cvalenciaMEMSYS/UniversalMotorModule/Motor_comparison/STSPIN220 new driver/M1/M1_summary_table.md

# M1 — Energy Measurement Results

Generated: 2026-02-09 14:13:06

## Complete Test Matrix

| Test ID | Speed | Voltage | Dir | Mean Power (mW) | Peak Power (mW) | Peak I (mA) | Energy (mJ) | Duration (ms) | Max Thrust (N) |
|---|---|---|-----|---|---|---|---|---|---|
| M1-CVH-4 | 10000 | 4V | N | 937 | 1375 | 390 | 1063 | 1134 | 5.19 |
| M1-CVH-5 | 10000 | 5V | N | 1425 | 2065 | 442 | 1652 | 1159 | 5.93 |
| M1-CVH-6 | 10000 | 6V | N | 1712 | 2554 | 456 | 1943 | 1135 | 6.47 |

## Best Configuration Summary

| Goal | Test ID | Speed | Voltage | Mean Power (mW) | Energy (mJ) | Max Thrust (N) | Efficiency (mJ/N) |
|---|---|---|---|---|---|---|---|
| **Min Energy** | M1-CVH-4 | 10000 | 4V | 937 | 1063 | 5.19 | 204.6 |
| **Max Thrust** | M1-CVH-6 | 10000 | 6V | 1712 | 1943 | 6.47 | 300.2 |
| **Best Efficiency** | M1-CVH-4 | 10000 | 4V | 937 | 1063 | 5.19 | 204.6 |
| **Balanced (5V)** | M1-CVH-5 | 10000 | 5V | 1425 | 1652 | 5.93 | 278.5 |
