cvalenciaMEMSYS/UniversalMotorModule/Motor_comparison/STSPIN220 new driver/M2/M2_summary_table.md

# M2 — Energy Measurement Results

Generated: 2026-02-09 14:27:09

## Complete Test Matrix

| Test ID | Speed | Voltage | Dir | Mean Power (mW) | Peak Power (mW) | Peak I (mA) | Energy (mJ) | Duration (ms) | Max Thrust (N) |
|---|---|---|-----|---|---|---|---|---|---|
| M2-CVH-3 | 10000 | 3V | N | 426 | 682 | 247 | 262 | 614 | 4.31 |
| M2-CVH-4 | 10000 | 4V | N | 760 | 1151 | 300 | 458 | 602 | 6.34 |
| M2-CVH-5 | 10000 | 5V | N | 1171 | 1672 | 359 | 715 | 610 | 7.03 |
| M2-CVH-6 | 10000 | 6V | N | 1514 | 2251 | 379 | 943 | 623 | 7.87 |
| M2-CUH-2 | 20000 | 2V | N | 154 | 273 | 152 | 58 | 377 | 2.71 |
| M2-CUH-3 | 20000 | 3V | N | 368 | 615 | 222 | 138 | 375 | 3.98 |

## Best Configuration Summary

| Goal | Test ID | Speed | Voltage | Mean Power (mW) | Energy (mJ) | Max Thrust (N) | Efficiency (mJ/N) |
|---|---|---|---|---|---|---|---|
| **Min Energy** | M2-CUH-2 | 20000 | 2V | 154 | 58 | 2.71 | 21.4 |
| **Max Thrust** | M2-CVH-6 | 10000 | 6V | 1514 | 943 | 7.87 | 119.9 |
| **Best Efficiency** | M2-CUH-2 | 20000 | 2V | 154 | 58 | 2.71 | 21.4 |
| **Balanced (5V)** | M2-CVH-5 | 10000 | 5V | 1171 | 715 | 7.03 | 101.6 |
