cvalenciaMEMSYS/UniversalMotorModule/Motor_comparison/DC Motors/D4/Constant load/D4_summary_table.md

# D4 — Energy Measurement Results

Generated: 2026-03-26 16:34:23

## Complete Test Matrix

| Test ID | Type | Speed | Voltage | Dir | Mean Power (mW) | Peak Power (mW) | Peak I (mA) | Energy (mJ) | Duration (ms) | Max Thrust (N) |
|---|---|---|---|-----|---|---|---|---|---|---|
| D4-CL-300g-3V3-N | CL | 100 | 3.3V | N | 72 | 215 | 65 | 1257 | 17509 | N/A |
| D4-CL-580g-3V3-N | CL | 100 | 3.3V | N | 99 | 225 | 68 | 1996 | 20163 | N/A |
| D4-CL-300g-6V-N | CL | 100 | 6.0V | N | 142 | 709 | 119 | 1246 | 8773 | N/A |
| D4-CL-580g-6V-N | CL | 100 | 6.0V | N | 188 | 711 | 119 | 1782 | 9468 | N/A |

## Best Configuration Summary

| Goal | Test ID | Type | Speed | Voltage | Mean Power (mW) | Energy (mJ) | Max Thrust (N) | Efficiency (mJ/N) |
|---|---|---|---|---|---|---|---|---|
| **Min Energy** | D4-CL-300g-6V-N | CL | 100 | 6.0V | 142 | 1246 | N/A | N/A |
