cvalenciaMEMSYS/UniversalMotorModule/Motor_comparison/DC Motors/D4/Held back/D4_summary_table.md

# D4 — Energy Measurement Results

Generated: 2026-03-26 15:02:04

## Complete Test Matrix

| Test ID | Type | Speed | Voltage | Dir | Mean Power (mW) | Peak Power (mW) | Peak I (mA) | Energy (mJ) | Duration (ms) | Max Thrust (N) |
|---|---|---|---|-----|---|---|---|---|---|---|
| D4-DC-3 | DC | 100% | 3V | N | 143 | 252 | 77 | 725 | 5057 | 13.35 |
| D4-DC-4 | DC | 100% | 4V | N | 228 | 392 | 99 | 1150 | 5054 | 14.95 |
| D4-DC-5 | DC | 100% | 5V | N | 228 | 489 | 98 | 1386 | 6089 | 15.44 |
| D4-DC-6 | DC | 100% | 6V | N | 266 | 708 | 118 | 1614 | 6075 | 14.50 |

## Best Configuration Summary

| Goal | Test ID | Type | Speed | Voltage | Mean Power (mW) | Energy (mJ) | Max Thrust (N) | Efficiency (mJ/N) |
|---|---|---|---|---|---|---|---|---|
| **Min Energy** | D4-DC-3 | DC | 100% | 3V | 143 | 725 | 13.35 | 54.3 |
| **Max Thrust** | D4-DC-5 | DC | 100% | 5V | 228 | 1386 | 15.44 | 89.8 |
| **Best Efficiency** | D4-DC-3 | DC | 100% | 3V | 143 | 725 | 13.35 | 54.3 |
| **Balanced (5V)** | D4-DC-5 | DC | 100% | 5V | 228 | 1386 | 15.44 | 89.8 |
