cvalenciaMEMSYS/UniversalMotorModule/Motor_comparison/DC Motors/D1/Fixed mounting/D1_fixed_summary_table.md

# D1 — Energy Measurement Results

Generated: 2026-02-17 10:46:12

## Complete Test Matrix

| Test ID | Type | Speed | Voltage | Dir | Mean Power (mW) | Peak Power (mW) | Peak I (mA) | Energy (mJ) | Duration (ms) | Max Thrust (N) |
|---|---|---|---|-----|---|---|---|---|---|---|
| D1-DC-3 | DC | 100% | 3V | N | 90 | 234 | 78 | 2168 | 23993 | 7.96 |
| D1-DC-4 | DC | 100% | 4V | N | 243 | 358 | 90 | 5825 | 23942 | 14.18 |
| D1-DC-5 | DC | 100% | 5V | N | 237 | 522 | 104 | 5664 | 23906 | 20.74 |
| D1-DC-6 | DC | 100% | 6V | N | 296 | 697 | 116 | 7077 | 23928 | 24.12 |

## Best Configuration Summary

| Goal | Test ID | Type | Speed | Voltage | Mean Power (mW) | Energy (mJ) | Max Thrust (N) | Efficiency (mJ/N) |
|---|---|---|---|---|---|---|---|---|
| **Min Energy** | D1-DC-3 | DC | 100% | 3V | 90 | 2168 | 7.96 | 272.3 |
| **Max Thrust** | D1-DC-6 | DC | 100% | 6V | 296 | 7077 | 24.12 | 293.5 |
| **Best Efficiency** | D1-DC-3 | DC | 100% | 3V | 90 | 2168 | 7.96 | 272.3 |
| **Balanced (5V)** | D1-DC-5 | DC | 100% | 5V | 237 | 5664 | 20.74 | 273.1 |
