cvalenciaMEMSYS/UniversalMotorModule/Motor_comparison/DC Motors/D1/Held back/D1_summary_table.md

# D1 — Energy Measurement Results

Generated: 2026-02-17 10:41:56

## Complete Test Matrix

| Test ID | Type | Speed | Voltage | Dir | Mean Power (mW) | Peak Power (mW) | Peak I (mA) | Energy (mJ) | Duration (ms) | Max Thrust (N) |
|---|---|---|---|-----|---|---|---|---|---|---|
| D1-DC-2 | DC | 100% | 2V | N | 48 | 115 | 48 | 1158 | 23961 | 28.42 |
| D1-DC-3 | DC | 100% | 3V | N | 80 | 178 | 59 | 1916 | 23951 | 37.58 |
| D1-DC-4 | DC | 100% | 4V | N | 115 | 316 | 79 | 2760 | 23980 | 45.05 |
| D1-DC-5 | DC | 100% | 5V | N | 204 | 492 | 98 | 4876 | 23870 | 55.33 |
| D1-DC-6 | DC | 100% | 6V | N | 229 | 697 | 116 | 5465 | 23889 | 54.54 |

## Best Configuration Summary

| Goal | Test ID | Type | Speed | Voltage | Mean Power (mW) | Energy (mJ) | Max Thrust (N) | Efficiency (mJ/N) |
|---|---|---|---|---|---|---|---|---|
| **Min Energy** | D1-DC-2 | DC | 100% | 2V | 48 | 1158 | 28.42 | 40.7 |
| **Max Thrust** | D1-DC-5 | DC | 100% | 5V | 204 | 4876 | 55.33 | 88.1 |
| **Best Efficiency** | D1-DC-2 | DC | 100% | 2V | 48 | 1158 | 28.42 | 40.7 |
| **Balanced (5V)** | D1-DC-5 | DC | 100% | 5V | 204 | 4876 | 55.33 | 88.1 |
