cvalenciaMEMSYS/UniversalMotorModule/Motor_comparison/DC Motors/D2/Held back Constant load/D2_ConstantLoad300g_summary_table.md

# D2 — Energy Measurement Results

Generated: 2026-02-17 10:52:14

## Complete Test Matrix

| Test ID | Type | Speed | Voltage | Dir | Mean Power (mW) | Peak Power (mW) | Peak I (mA) | Energy (mJ) | Duration (ms) | Max Thrust (N) |
|---|---|---|---|-----|---|---|---|---|---|---|
| D2-DC-6 | DC | 100% | 6V | N | 153 | 657 | 110 | 3369 | 22077 | N/A |

## Best Configuration Summary

| Goal | Test ID | Type | Speed | Voltage | Mean Power (mW) | Energy (mJ) | Max Thrust (N) | Efficiency (mJ/N) |
|---|---|---|---|---|---|---|---|---|
| **Min Energy** | D2-DC-6 | DC | 100% | 6V | 153 | 3369 | N/A | N/A |
