cvalenciaMEMSYS/UniversalMotorModule/Motor_comparison/DC Motors/D2/Held back Constant load/D2_ConstantLoad580g_summary_table.md

# D2 — Energy Measurement Results

Generated: 2026-02-17 10:54:47

## Complete Test Matrix

| Test ID | Type | Speed | Voltage | Dir | Mean Power (mW) | Peak Power (mW) | Peak I (mA) | Energy (mJ) | Duration (ms) | Max Thrust (N) |
|---|---|---|---|-----|---|---|---|---|---|---|
| D2-DC-6 | DC | 100% | 6V | N | 186 | 658 | 111 | 4108 | 22130 | N/A |

## Best Configuration Summary

| Goal | Test ID | Type | Speed | Voltage | Mean Power (mW) | Energy (mJ) | Max Thrust (N) | Efficiency (mJ/N) |
|---|---|---|---|---|---|---|---|---|
| **Min Energy** | D2-DC-6 | DC | 100% | 6V | 186 | 4108 | N/A | N/A |
