cvalenciaMEMSYS/UniversalMotorModule/Motor_comparison/DC Motors/D2/Held back/D2_summary_table.md

# D2 — Energy Measurement Results

Generated: 2026-02-17 10:58:02

## Complete Test Matrix

| Test ID | Type | Speed | Voltage | Dir | Mean Power (mW) | Peak Power (mW) | Peak I (mA) | Energy (mJ) | Duration (ms) | Max Thrust (N) |
|---|---|---|---|-----|---|---|---|---|---|---|
| D2-DC-2 | DC | 100% | 2V | N | 68 | 128 | 54 | 501 | 7353 | 15.80 |
| D2-DC-3 | DC | 100% | 3V | N | 108 | 185 | 62 | 798 | 7382 | 19.82 |
| D2-DC-4 | DC | 100% | 4V | N | 191 | 341 | 85 | 1405 | 7350 | 29.23 |
| D2-DC-5 | DC | 100% | 5V | N | 283 | 529 | 106 | 2091 | 7384 | 36.66 |
| D2-DC-6 | DC | 100% | 6V | N | 309 | 757 | 127 | 2274 | 7370 | 48.26 |

## Best Configuration Summary

| Goal | Test ID | Type | Speed | Voltage | Mean Power (mW) | Energy (mJ) | Max Thrust (N) | Efficiency (mJ/N) |
|---|---|---|---|---|---|---|---|---|
| **Min Energy** | D2-DC-2 | DC | 100% | 2V | 68 | 501 | 15.80 | 31.7 |
| **Max Thrust** | D2-DC-6 | DC | 100% | 6V | 309 | 2274 | 48.26 | 47.1 |
| **Best Efficiency** | D2-DC-2 | DC | 100% | 2V | 68 | 501 | 15.80 | 31.7 |
| **Balanced (5V)** | D2-DC-5 | DC | 100% | 5V | 283 | 2091 | 36.66 | 57.0 |
