cvalenciaMEMSYS/UniversalMotorModule/Motor_comparison/DC Motors/D3/Held back/D3_summary_table.md

# D3 — Energy Measurement Results

Generated: 2026-02-17 11:03:01

## Complete Test Matrix

| Test ID | Type | Speed | Voltage | Dir | Mean Power (mW) | Peak Power (mW) | Peak I (mA) | Energy (mJ) | Duration (ms) | Max Thrust (N) |
|---|---|---|---|-----|---|---|---|---|---|---|
| D3-DC-3 | DC | 100% | 3V | N | 80 | 213 | 71 | 82 | 1027 | 3.07 |
| D3-DC-4 | DC | 100% | 4V | N | 100 | 386 | 97 | 103 | 1030 | 4.13 |
| D3-DC-5 | DC | 100% | 5V | N | 334 | 518 | 104 | 345 | 1032 | 4.97 |
| D3-DC-6 | DC | 100% | 6V | N | 436 | 797 | 134 | 445 | 1023 | 6.50 |

## Best Configuration Summary

| Goal | Test ID | Type | Speed | Voltage | Mean Power (mW) | Energy (mJ) | Max Thrust (N) | Efficiency (mJ/N) |
|---|---|---|---|---|---|---|---|---|
| **Min Energy** | D3-DC-3 | DC | 100% | 3V | 80 | 82 | 3.07 | 26.7 |
| **Max Thrust** | D3-DC-6 | DC | 100% | 6V | 436 | 445 | 6.50 | 68.5 |
| **Best Efficiency** | D3-DC-4 | DC | 100% | 4V | 100 | 103 | 4.13 | 24.9 |
| **Balanced (5V)** | D3-DC-5 | DC | 100% | 5V | 334 | 345 | 4.97 | 69.4 |
