cvalenciaMEMSYS/UniversalMotorModule/Motor_comparison/M1/M1_summary_table.md

# M1 — Energy Measurement Results

Generated: 2026-01-30 14:25:04

## Complete Test Matrix

| Test ID | Speed | Voltage | Dir | Mean Power (mW) | Peak Power (mW) | Peak I (mA) | Energy (mJ) | Duration (ms) | Max Thrust (N) |
|---|---|---|-----|---|---|---|---|---|---|
| M1-CVL-4 | 100 | 4V | N | 534 | 1329 | 344 | 16365 | 30625 | 4.42 |
| M1-CVL-5 | 100 | 5V | N | 813 | 2080 | 412 | 20814 | 25602 | 4.59 |
| M1-CVL-6 | 100 | 6V | N | 1063 | 2920 | 507 | 27117 | 25518 | 4.99 |
| M1-CL-4 | 500 | 4V | N | 364 | 1245 | 296 | 3819 | 10501 | 3.67 |
| M1-CL-5 | 500 | 5V | N | 651 | 2055 | 371 | 6850 | 10517 | 4.61 |
| M1-CL-6 | 500 | 6V | N | 595 | 2329 | 408 | 6247 | 10502 | 4.70 |
| M1-CM-4 | 2000 | 4V | N | 340 | 1253 | 300 | 951 | 2795 | 3.89 |
| M1-CM-5 | 2000 | 5V | N | 574 | 2122 | 377 | 1597 | 2782 | 5.16 |
| M1-CM-6 | 2000 | 6V | N | 636 | 2996 | 501 | 1774 | 2788 | 5.07 |
| M1-CH-4 | 5000 | 4V | N | 506 | 1373 | 337 | 701 | 1385 | 4.89 |
| M1-CH-5 | 5000 | 5V | N | 837 | 2201 | 428 | 1182 | 1412 | 5.69 |
| M1-CH-6 | 5000 | 6V | N | 804 | 2375 | 451 | 1141 | 1418 | 5.42 |
| M1-CVH-4 | 10000 | 4V | N | 298 | 1399 | 343 | 412 | 1386 | 3.65 |
| M1-TVH-4 | 10000 | 4V | N | 364 | 1320 | 321 | 1605 | 4404 | 4.37 |
| M1-CVH-4-R | 10000 | 4V | R | 265 | 1396 | 342 | 375 | 1416 | N/A |
| M1-CVH-5 | 10000 | 5V | N | 485 | 2271 | 428 | 673 | 1389 | 4.83 |
| M1-CVH-5-R | 10000 | 5V | R | 448 | 2269 | 431 | 628 | 1401 | N/A |
| M1-CVH-6 | 10000 | 6V | N | 517 | 3302 | 494 | 723 | 1398 | 5.18 |
| M1-TVH-6 | 10000 | 6V | N | 666 | 2944 | 445 | 3019 | 4534 | N/A |
| M1-CVH-6-R | 10000 | 6V | R | 482 | 3145 | 472 | 666 | 1381 | N/A |

## Backdrive Force Results

| Test ID | Direction | Max Force (N) | Mean Force (N) |
|---|---|---|---|
| M1-BD-OFF-Rigid | Rigid | 10.39 | 2.80 |
| M1-BD-OFF-Spring | Spring | 8.17 | 4.63 |

## Best Configuration Summary

| Goal | Test ID | Speed | Voltage | Mean Power (mW) | Energy (mJ) | Max Thrust (N) | Efficiency (mJ/N) |
|---|---|---|---|---|---|---|---|
| **Min Energy** | M1-CVH-4-R | 10000 | 4V | 265 | 375 | N/A | N/A |
| **Max Thrust** | M1-CH-5 | 5000 | 5V | 837 | 1182 | 5.69 | 207.6 |
| **Best Efficiency** | M1-CVH-4 | 10000 | 4V | 298 | 412 | 3.65 | 112.9 |
| **Balanced (5V)** | M1-CVH-5 | 10000 | 5V | 485 | 673 | 4.83 | 139.3 |
