cvalenciaMEMSYS/UniversalMotorModule/Motor_comparison/M2/M2_summary_table.md

# M2 — Energy Measurement Results

Generated: 2026-01-30 14:49:28

## Complete Test Matrix

| Test ID | Speed | Voltage | Dir | Mean Power (mW) | Peak Power (mW) | Peak I (mA) | Energy (mJ) | Duration (ms) | Max Thrust (N) |
|---|---|---|-----|---|---|---|---|---|---|
| M2-CL-4 | 500 | 4V | N | 405 | 987 | 253 | 4265 | 10539 | 3.83 |
| M2-CL-4-R | 500 | 4V | R | 400 | 982 | 254 | 4193 | 10484 | 3.83 |
| M2-CL-5 | 500 | 5V | N | 602 | 1512 | 318 | 6321 | 10504 | 4.76 |
| M2-CL-5-R | 500 | 5V | R | 597 | 1508 | 315 | 6206 | 10402 | 5.72 |
| M2-CL-6 | 500 | 6V | N | 867 | 2294 | 364 | 9051 | 10442 | 6.51 |
| M2-CL-6-R | 500 | 6V | R | 862 | 2253 | 363 | 8987 | 10429 | N/A |
| M2-CVH-4 | 10000 | 4V | N | 264 | 1096 | 256 | 216 | 819 | 3.94 |
| M2-CVH-4-R | 10000 | 4V | R | 291 | 1053 | 251 | 231 | 794 | 3.94 |
| M2-CVH-5 | 10000 | 5V | N | 424 | 1726 | 324 | 339 | 800 | 5.74 |
| M2-CVH-5-R | 10000 | 5V | R | 430 | 1688 | 334 | 332 | 771 | 5.95 |
| M2-CVH-6 | 10000 | 6V | N | 572 | 2459 | 387 | 450 | 786 | 6.06 |
| M2-CVH-6-R | 10000 | 6V | R | 568 | 2413 | 383 | 457 | 805 | 6.06 |

## Backdrive Force Results

| Test ID | Direction | Max Force (N) | Mean Force (N) |
|---|---|---|---|
| M2-BD-OFF-N | N | 11.57 | 2.38 |
| M2-BD-OFF-R | R | 11.63 | 4.29 |

## Best Configuration Summary

| Goal | Test ID | Speed | Voltage | Mean Power (mW) | Energy (mJ) | Max Thrust (N) | Efficiency (mJ/N) |
|---|---|---|---|---|---|---|---|
| **Min Energy** | M2-CVH-4 | 10000 | 4V | 264 | 216 | 3.94 | 54.8 |
| **Max Thrust** | M2-CL-6 | 500 | 6V | 867 | 9051 | 6.51 | 1389.5 |
| **Best Efficiency** | M2-CVH-4 | 10000 | 4V | 264 | 216 | 3.94 | 54.8 |
| **Balanced (5V)** | M2-CVH-5-R | 10000 | 5V | 430 | 332 | 5.95 | 55.8 |
