cvalenciaMEMSYS/UniversalMotorModule/Motor_comparison/DC Motors/D1/Fixed mounting/D1_fixed_best_efficiency_raw_force.png

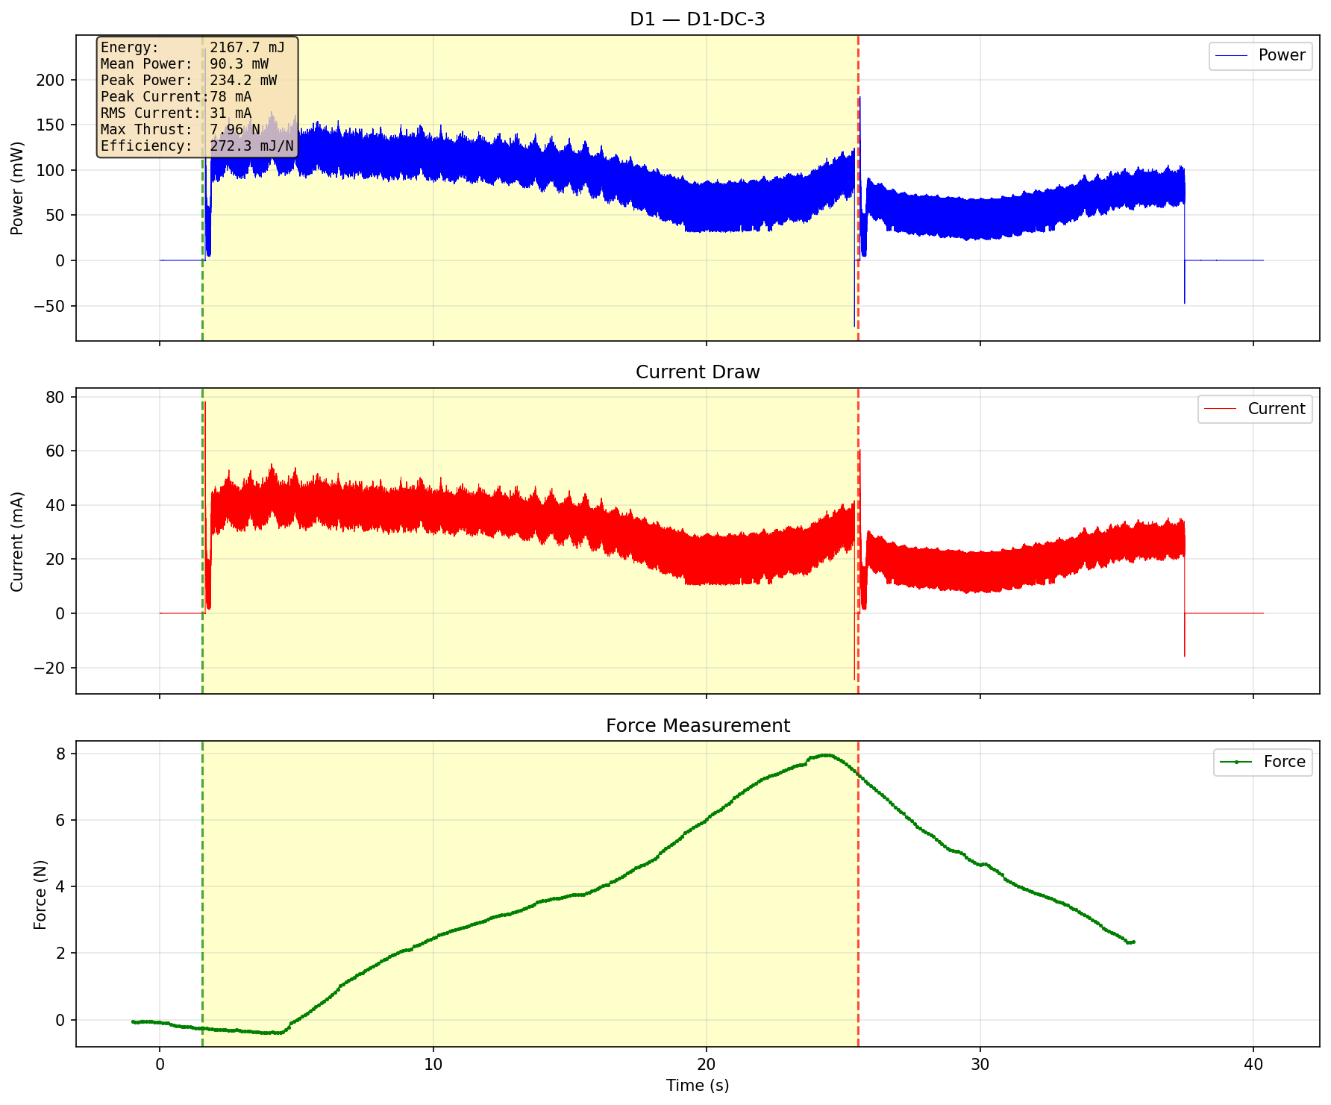
Motor_comparison/DC Motors/D1/Fixed mounting/D1_fixed_best_efficiency_raw_force.png
