cvalenciaMEMSYS/UniversalMotorModule/Motor_comparison/DC Motors/D1/Held back/D1_best_efficiency_raw_force.png

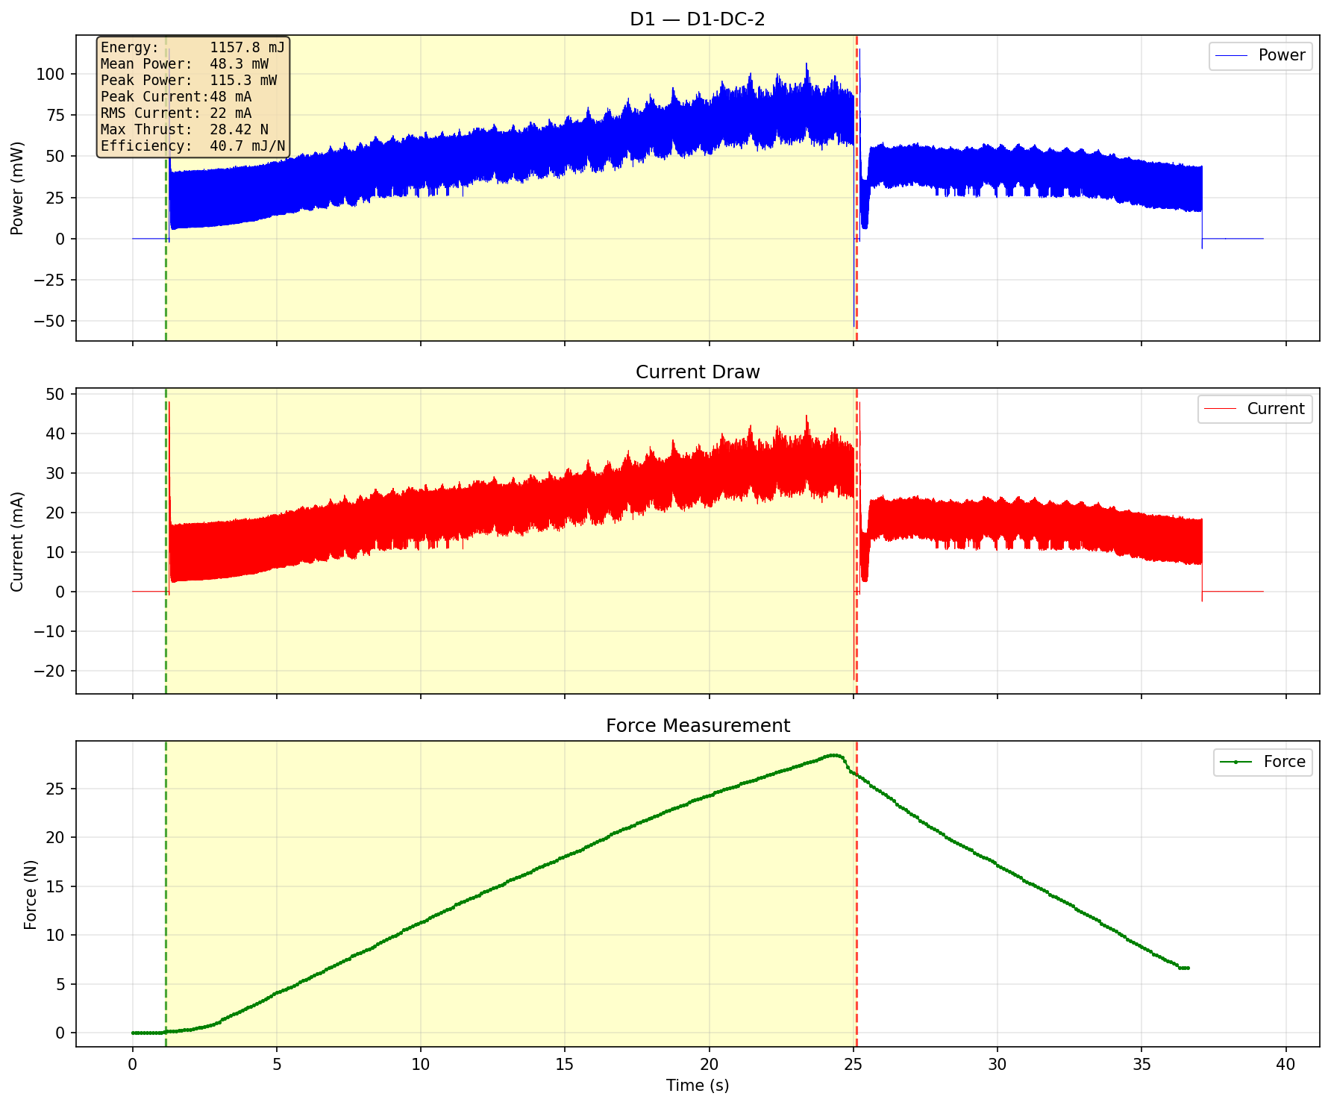
Motor_comparison/DC Motors/D1/Held back/D1_best_efficiency_raw_force.png
