cvalenciaMEMSYS/UniversalMotorModule/Motor_comparison/DC Motors/D2/Held back Constant load/D2_ConstantLoad300g_config.png

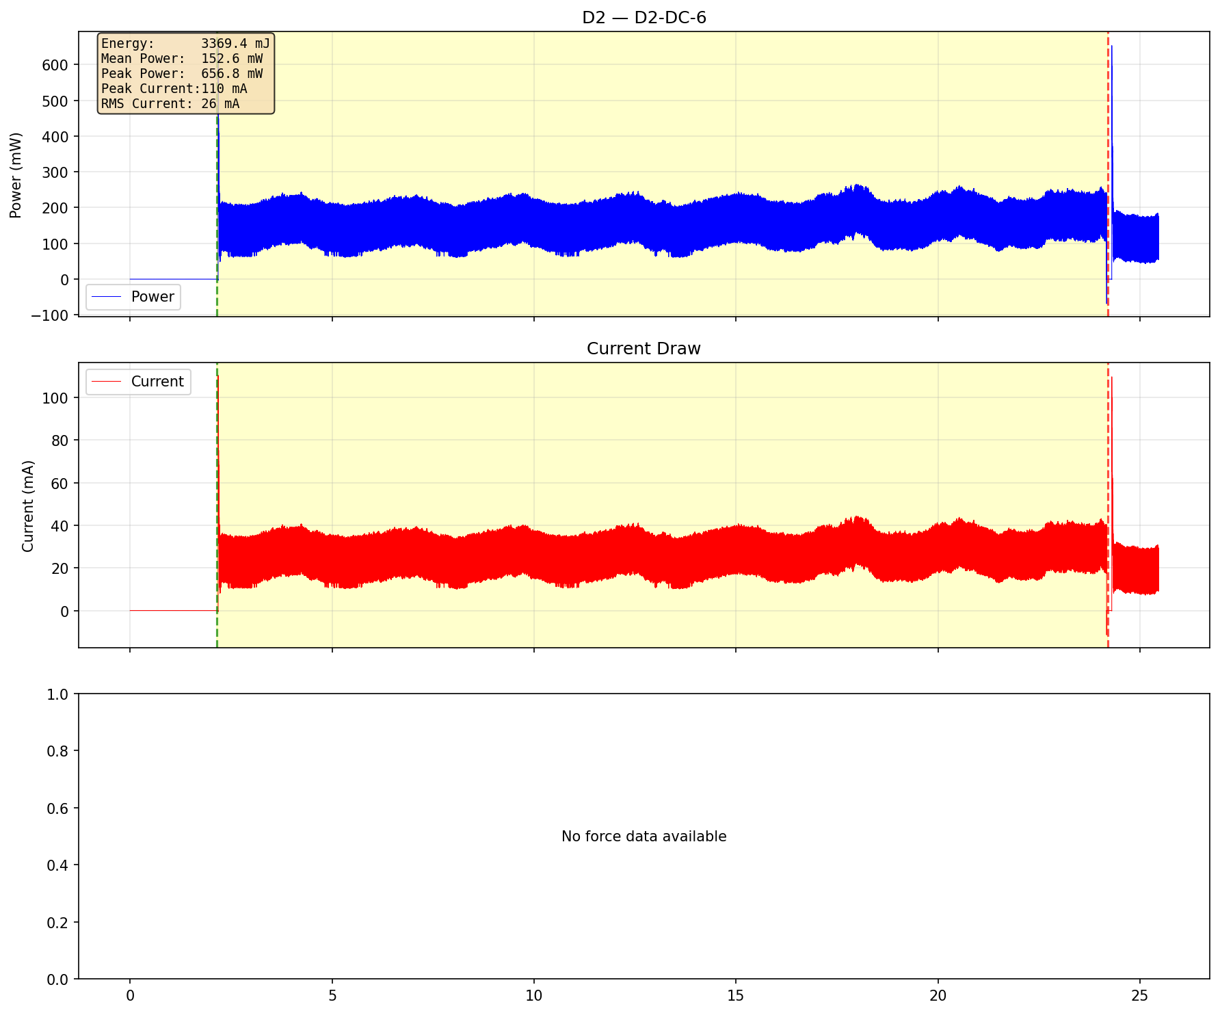
Motor_comparison/DC Motors/D2/Held back Constant load/D2_ConstantLoad300g_config.png
