cvalenciaMEMSYS/UniversalMotorModule/Motor_comparison/DC Motors/D2/Held back/D2_best_efficiency_raw_force.png

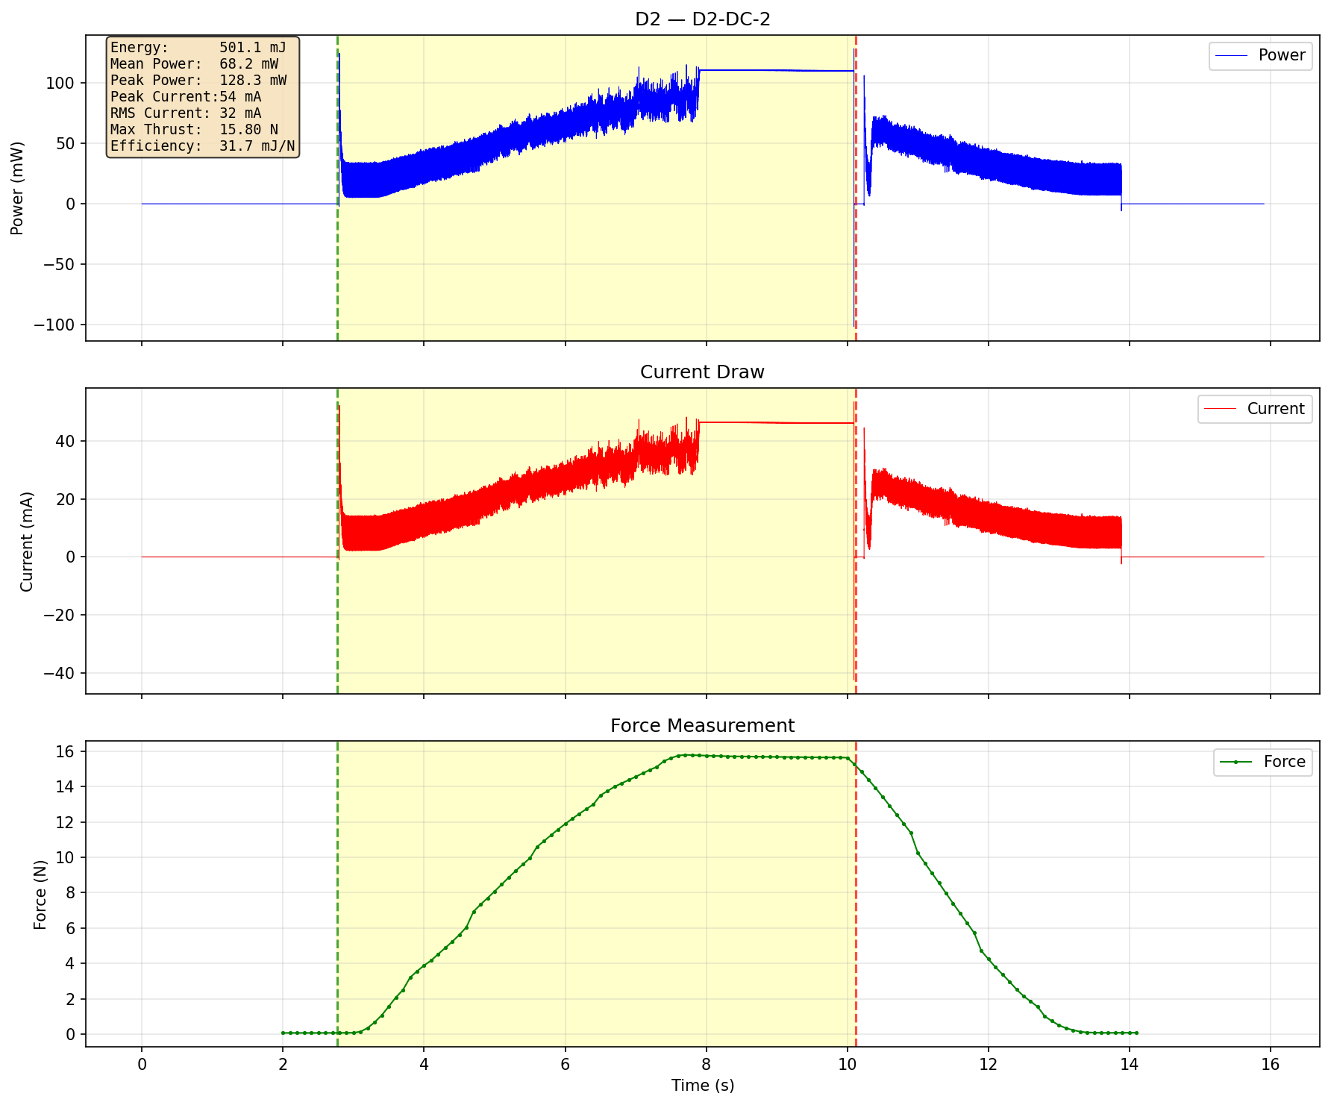
Motor_comparison/DC Motors/D2/Held back/D2_best_efficiency_raw_force.png
