cvalenciaMEMSYS/UniversalMotorModule/Motor_comparison/DC Motors/D3/Held back/D3_Best_efficiency_general.png

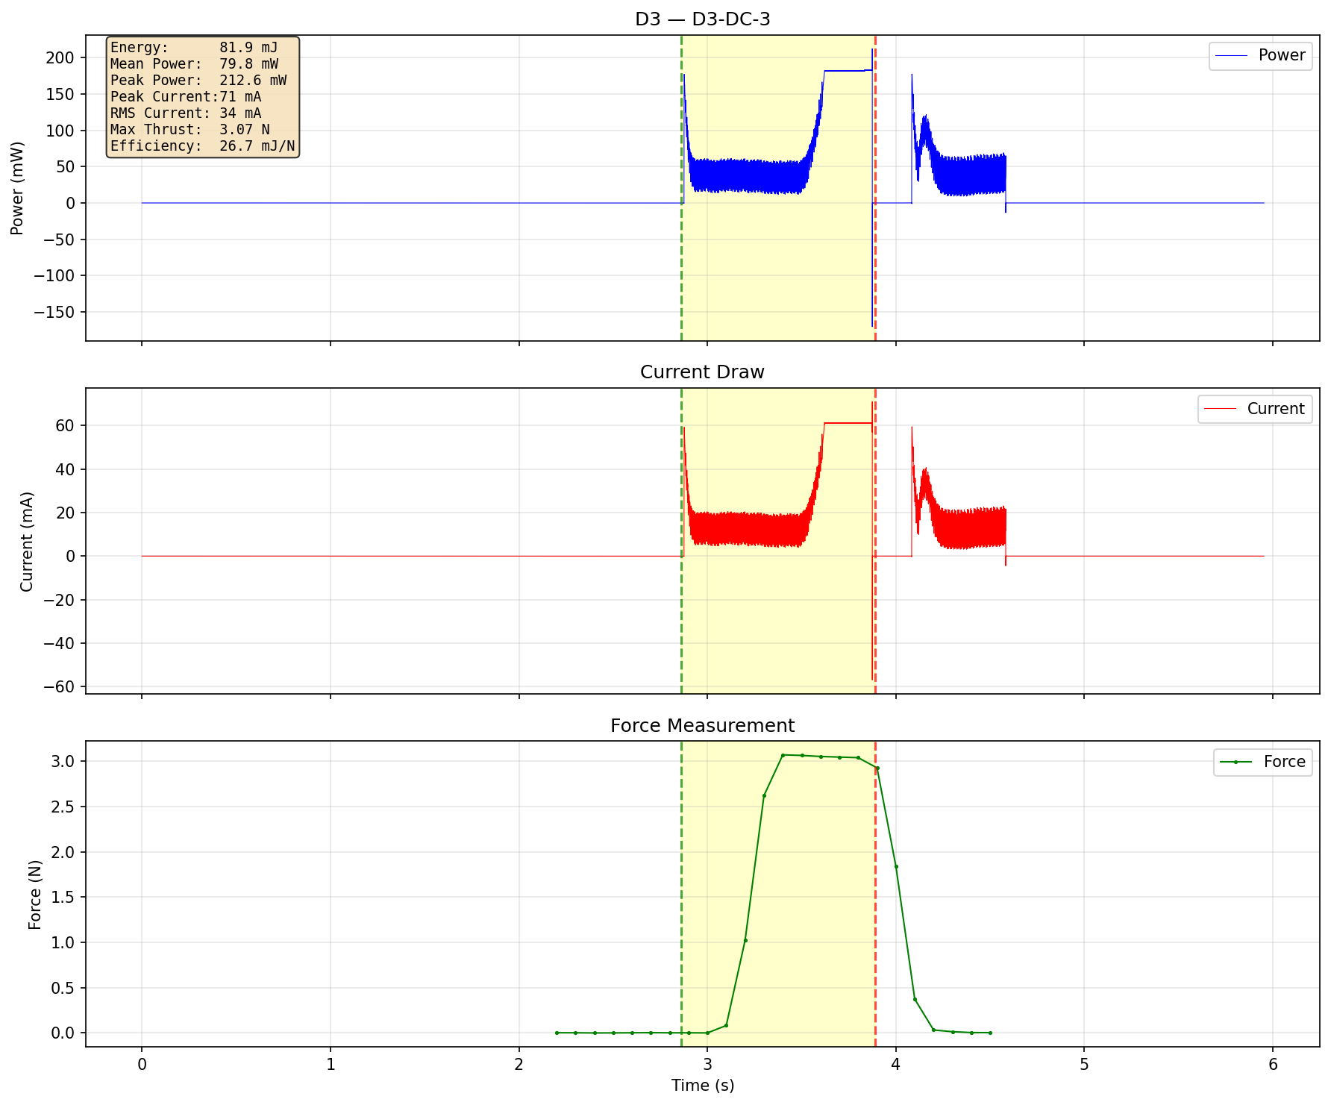
Motor_comparison/DC Motors/D3/Held back/D3_Best_efficiency_general.png
