cvalenciaMEMSYS/UniversalMotorModule/Motor_comparison/DC Motors/D3/Held back/D3_Best_efficiency_Over3.5N.png

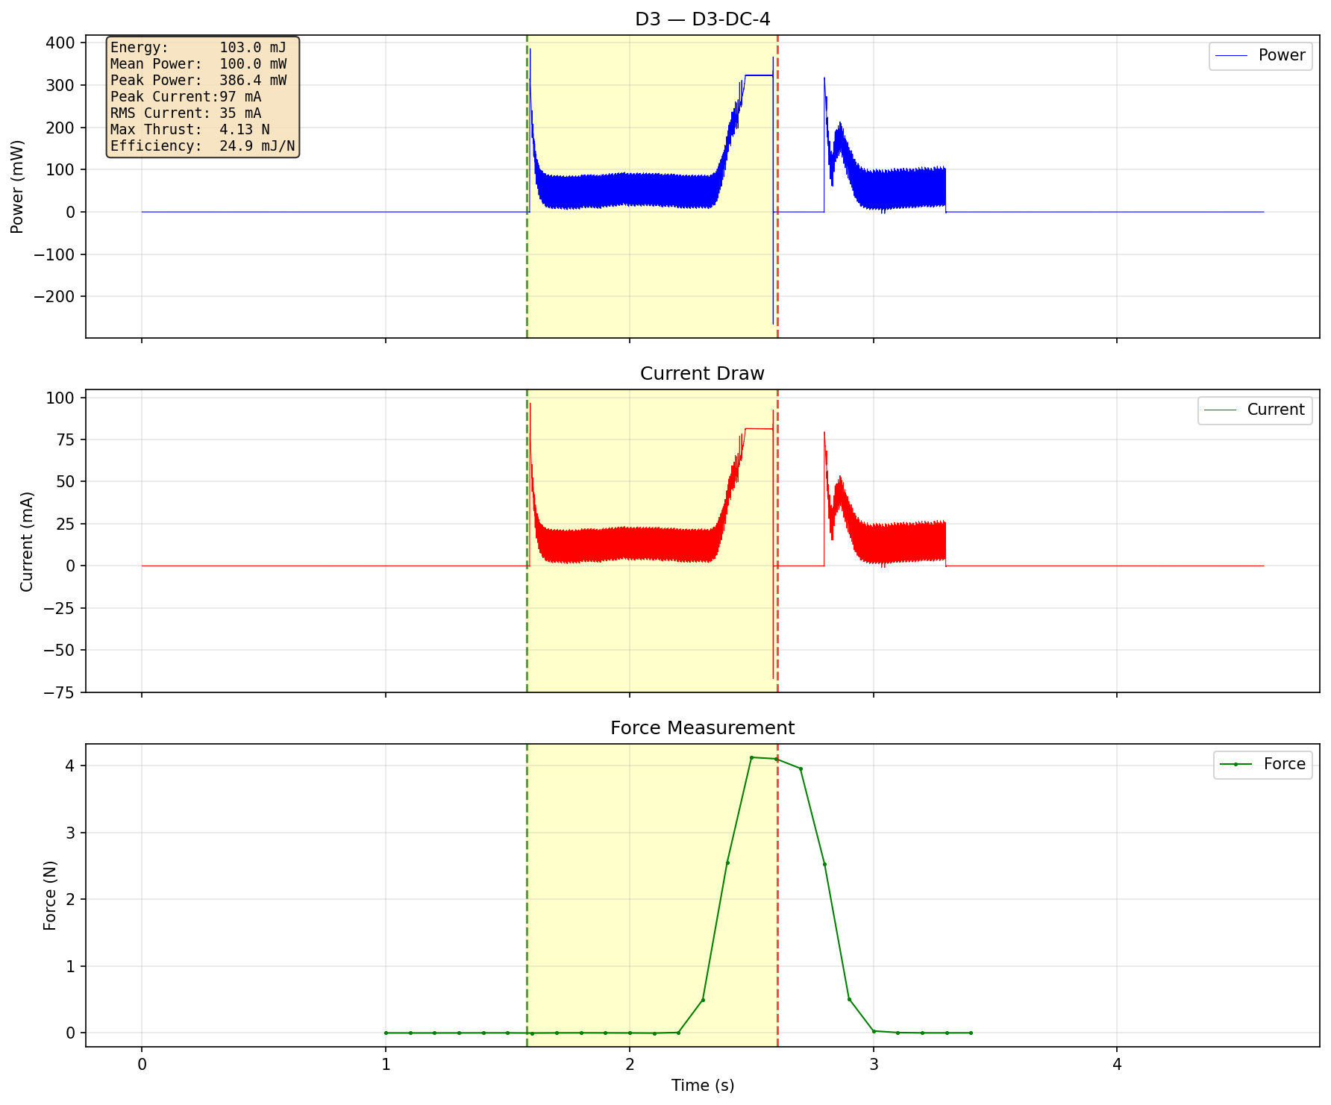
Motor_comparison/DC Motors/D3/Held back/D3_Best_efficiency_Over3.5N.png
