cvalenciaMEMSYS/UniversalMotorModule/Motor_comparison/DC Motors/D4/Constant load/D4_best_config.png

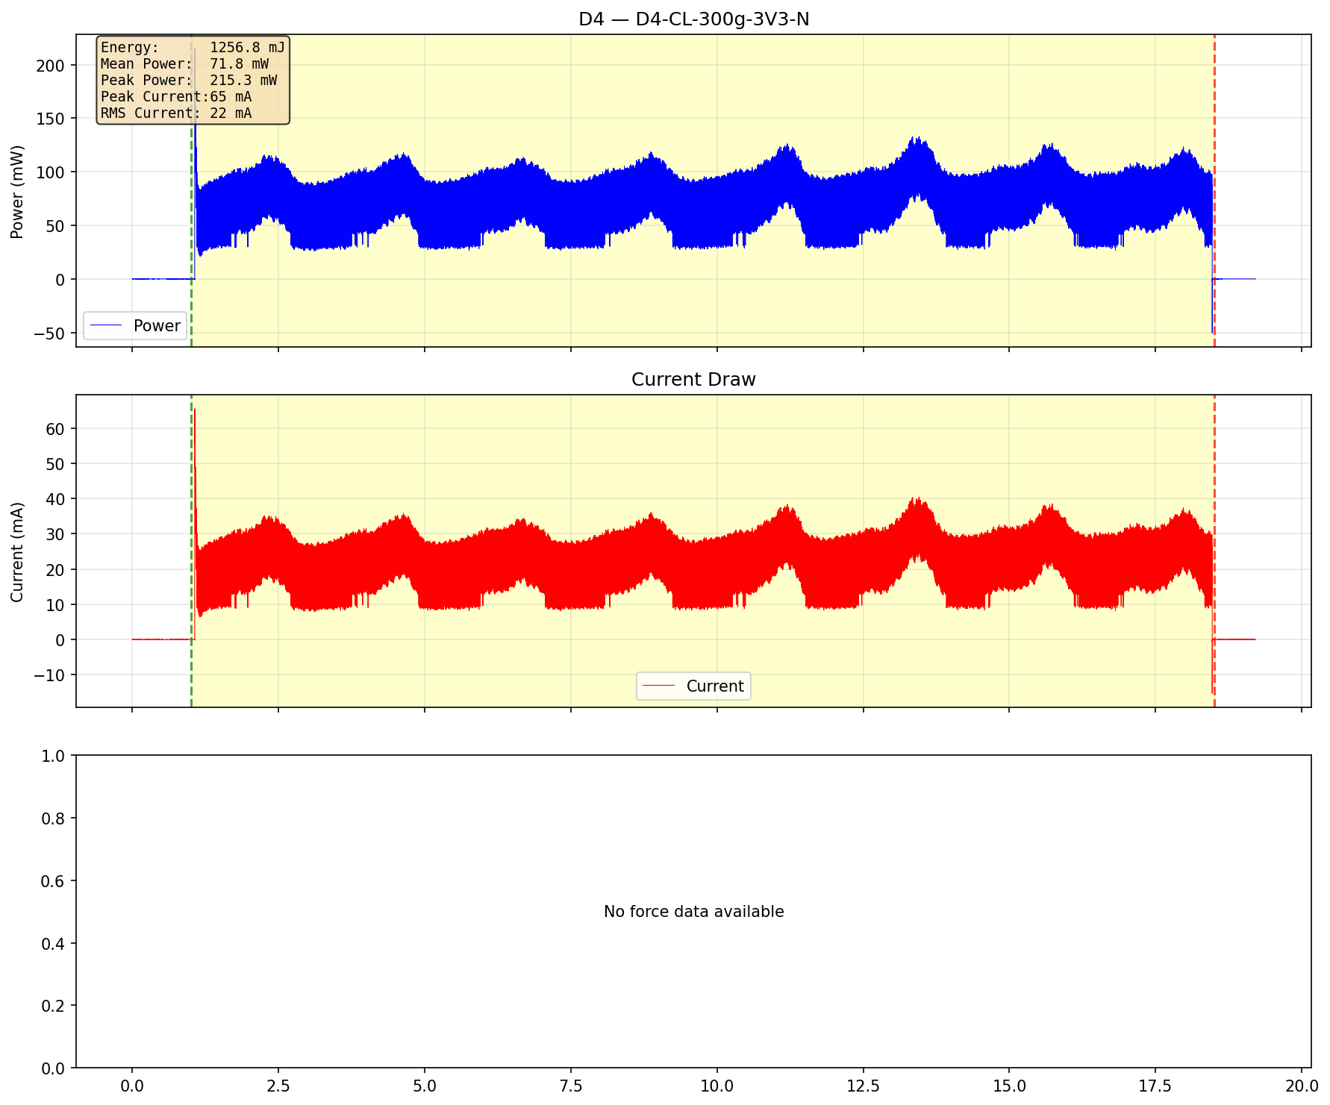
Motor_comparison/DC Motors/D4/Constant load/D4_best_config.png
