cvalenciaMEMSYS/UniversalMotorModule/Motor_comparison/DC Motors/D4/Held back/D4_best_config.png

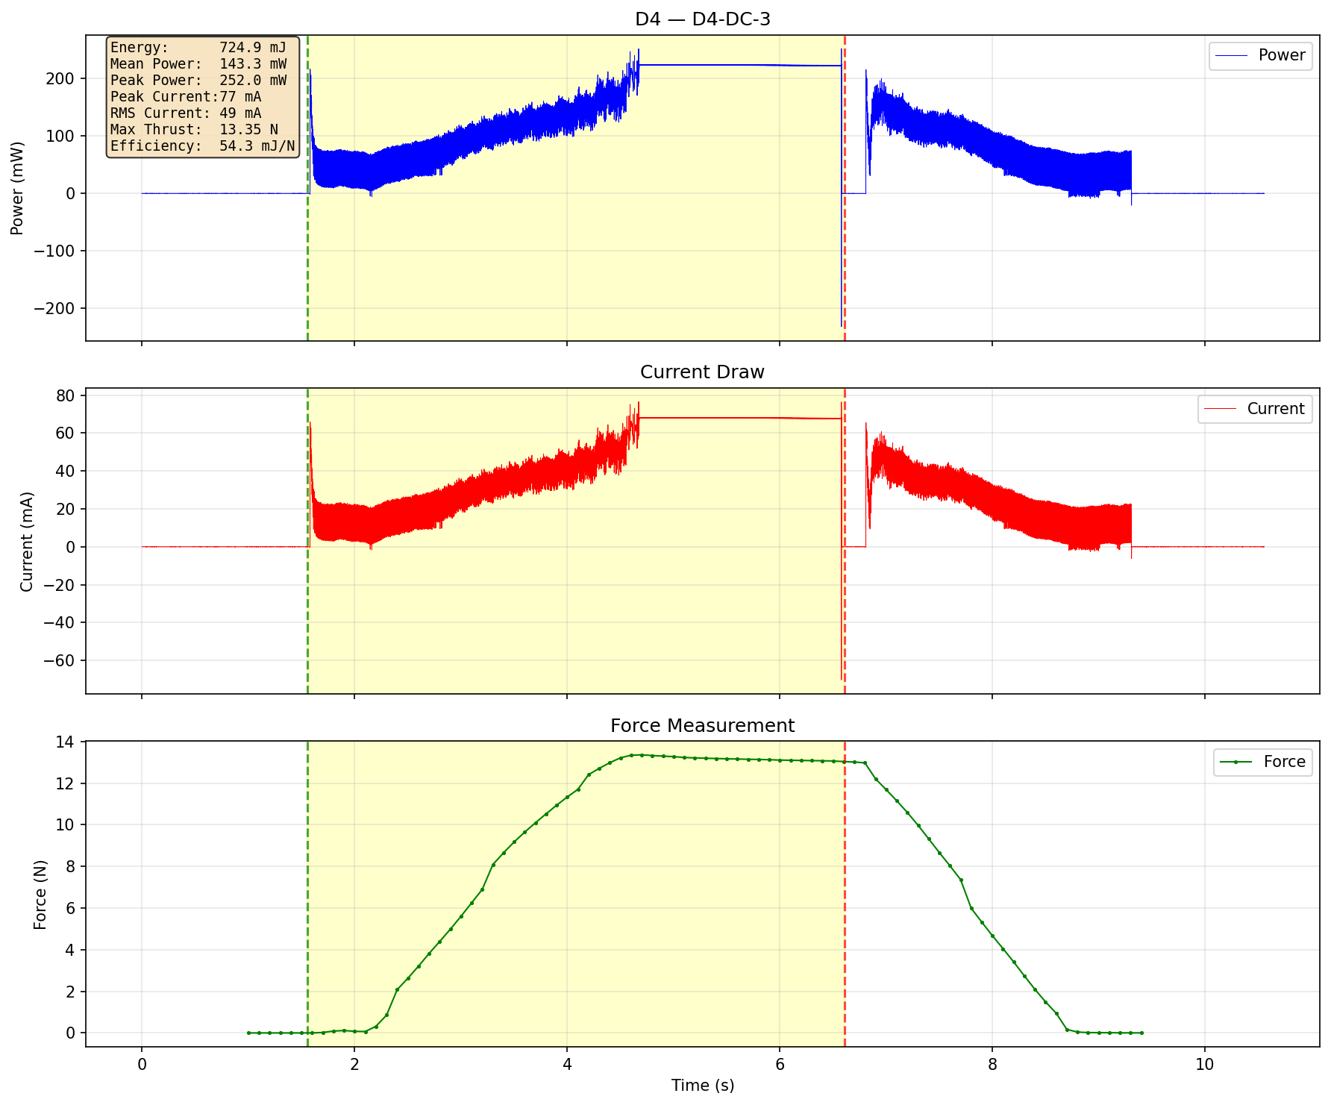
Motor_comparison/DC Motors/D4/Held back/D4_best_config.png
