cvalenciaMEMSYS/UniversalMotorModule/Motor_comparison/STSPIN220 new driver/M1/M1_best_config.png

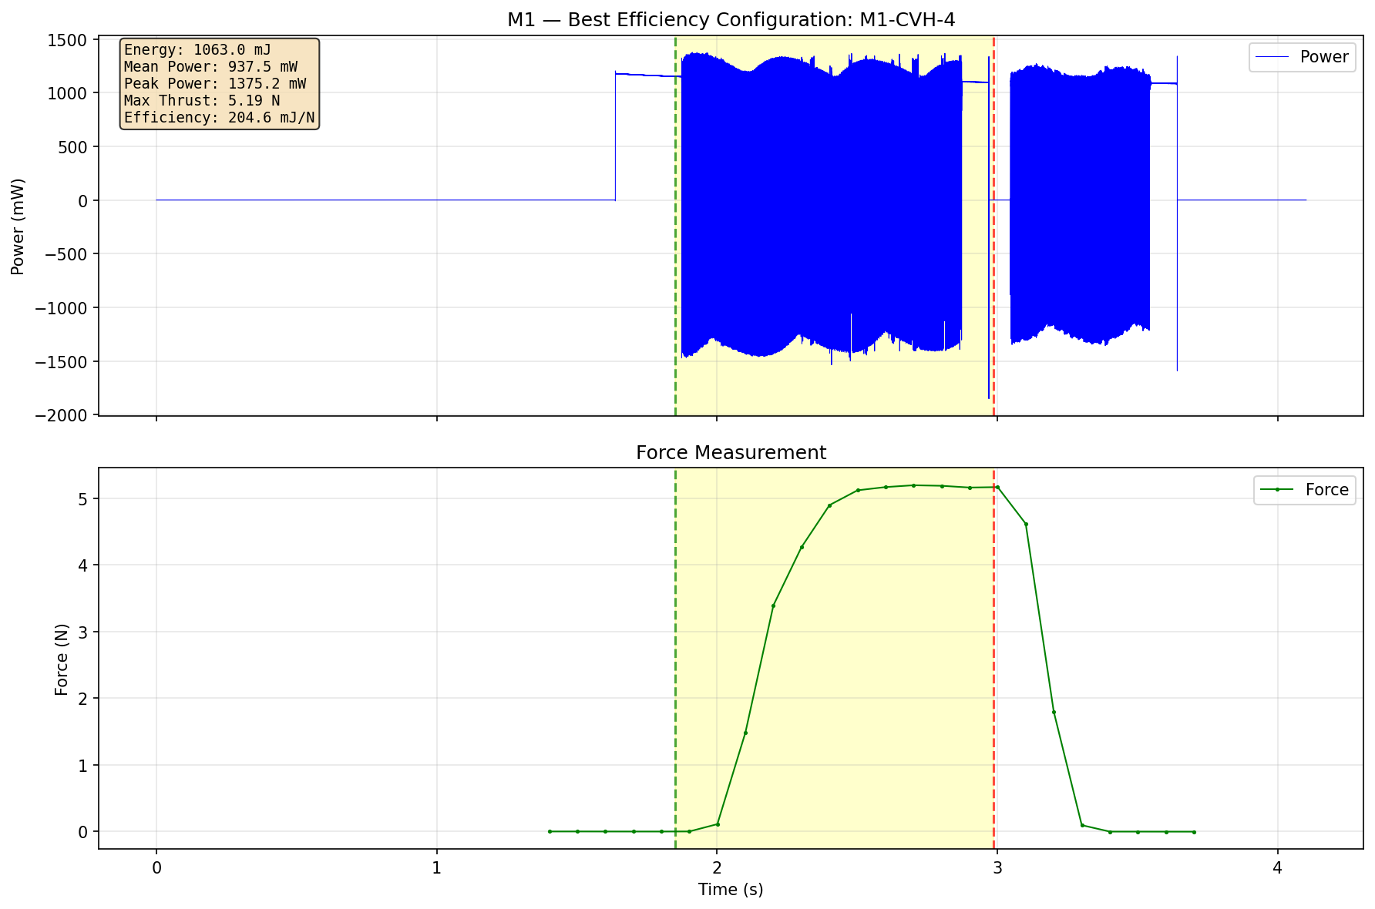
Motor_comparison/STSPIN220 new driver/M1/M1_best_config.png
