cvalenciaMEMSYS/UniversalMotorModule/Motor_comparison/STSPIN220 new driver/M2/M2_best_config.png

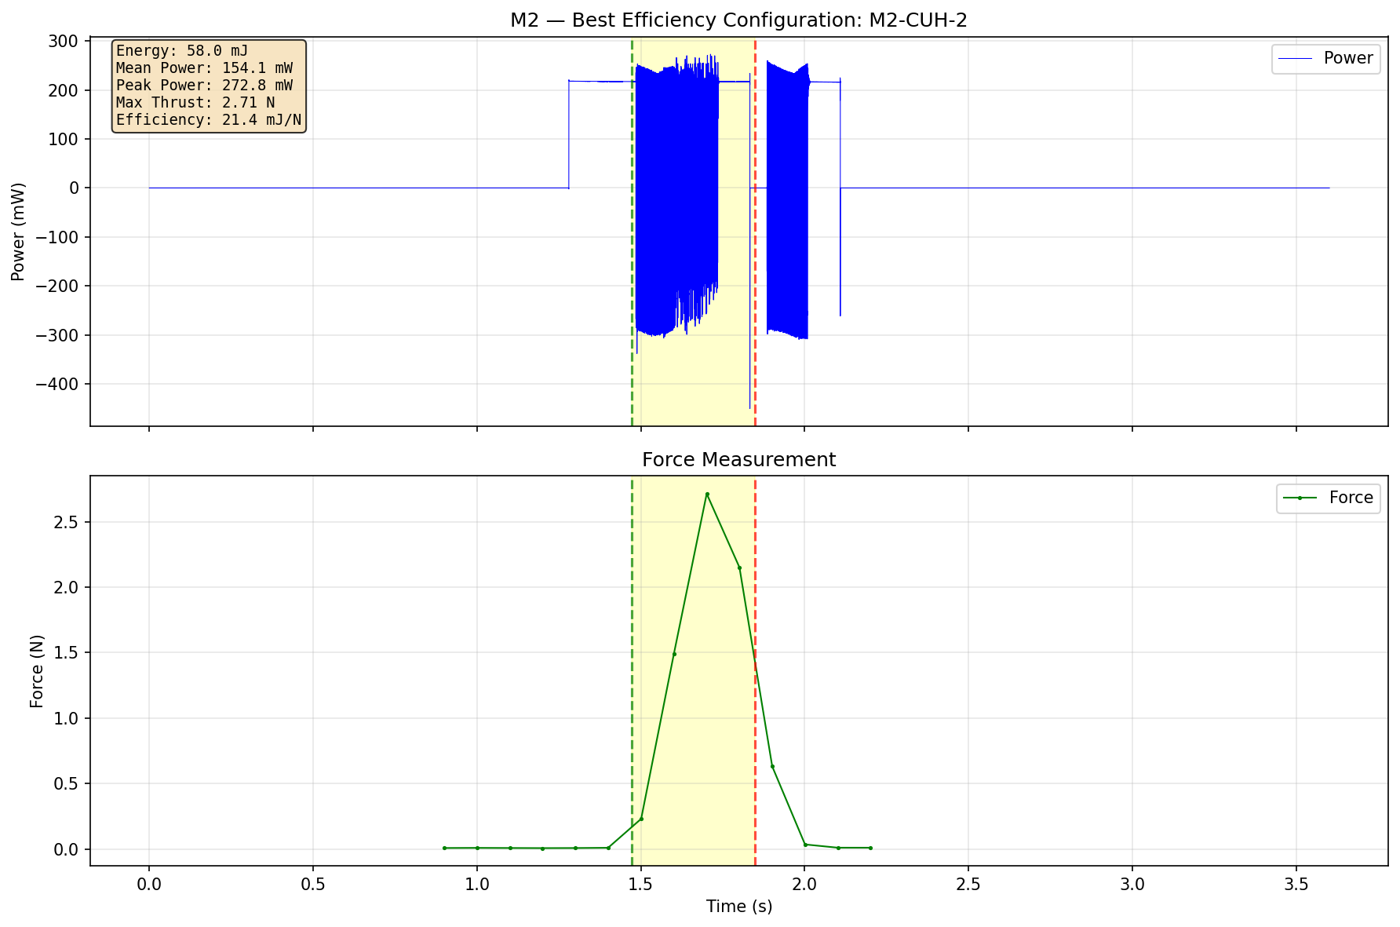
Motor_comparison/STSPIN220 new driver/M2/M2_best_config.png
