cvalenciaMEMSYS/UniversalMotorModule/Motor_comparison/STSPIN220 new driver/M2/M2_STSPIN220_best_config_over_3N5_force.png

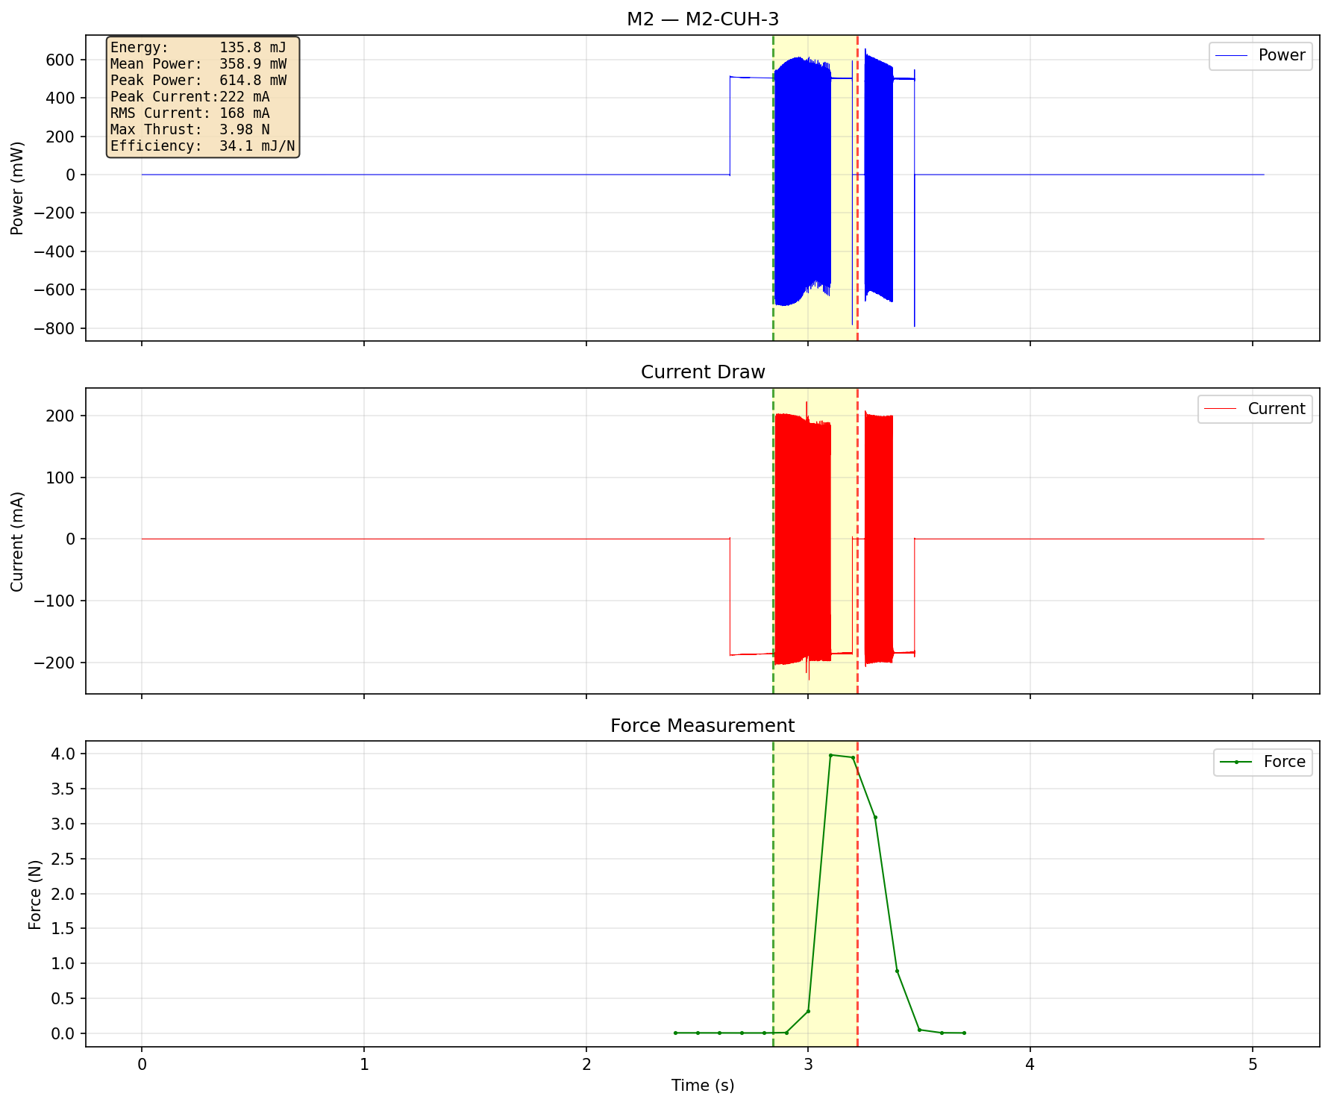
Motor_comparison/STSPIN220 new driver/M2/M2_STSPIN220_best_config_over_3N5_force.png
