cvalenciaMEMSYS/UniversalMotorModule/docs/Energy_Test_Results.xlsx

Sheet: Motor 1
Motor 1: ____________________
Constant Velocity Profile (set accel 0)
Speed VL (100 steps/s) |  |  |  |  |  |  | 2500 travel steps
ID | Voltage | Thrust (N) | Driver Power (mW) | Actuator Power (W) | Duration (ms) | Actuator Energy (mJ)
M1-CVL-3 | 3V | x | x | x | x | x | Not doable, minimum voltage for current driver 3.8V
M1-CVL-4 | 4V | 4 |  | 0.6 | 25000 | 15000
M1-CVL-5 | 5V | 4.5 |  | 0.8 | 25000 | 20000
M1-CVL-6 | 6V | 5 |  | 1.04 | 25000 | 26000
Speed L (500 steps/s) |  |  |  |  |  |  | 5000 travel steps
ID | Voltage | Thrust (N) | Driver Power (mW) | Actuator Power (W) | Duration (ms) | Actuator Energy (mJ)
M1-CL-3 | 3V | x | x | x | x | x
M1-CL-4 | 4V | 3.6 |  | 0.380952381 | 10500 | 4000
M1-CL-5 | 5V | 4.5 |  | 0.6380952381 | 10500 | 6700
M1-CL-6 | 6V | 4.5 |  | 0.6952380952 | 10500 | 7300
Speed M (2000 steps/s) |  |  |  |  |  |  | 5000 travel steps
ID | Voltage | Thrust (N) | Driver Power (mW) | Actuator Power (W) | Duration (ms) | Actuator Energy (mJ)
M1-CM-3 | 3V | x | x | x | x | x
M1-CM-4 | 4V | 3.9 |  | 0.3553571429 | 2800 | 995
M1-CM-5 | 5V | 5 |  | 0.5535714286 | 2800 | 1550
M1-CM-6 | 6V | 5 |  | 0.6071428571 | 2800 | 1700
Speed H (5000 steps/s) |  |  |  |  |  |  | 5000 travel steps
ID | Voltage | Thrust (N) | Driver Power (mW) | Actuator Power (W) | Duration (ms) | Actuator Energy (mJ)
M1-CH-3 | 3V | x | x | x | x | x
M1-CH-4 | 4V | 4.9 |  | 0.5307142857 | 1400 | 743
M1-CH-5 | 5V | 5.5 |  | 0.8571428571 | 1400 | 1200
M1-CH-6 | 6V | 5.3 |  | 0.9285714286 | 1400 | 1300
Speed VH (10000 steps/s) |  |  |  |  |  |  | 10000 travel steps
ID | Voltage | Thrust (N) | Driver Power (mW) | Actuator Power (W) | Duration (ms) | Actuator Energy (mJ) Normal direction-Reverse direction
M1-CVH-3 | 3V | x | x | x | x | x
M1-CVH-4 | 4V | 3.6-1.6 |  |  | 1400 | 450-411
M1-CVH-5 | 5V | 4.8-3 |  |  | 1400 | 700-650
M1-CVH-6 | 6V | 5.1-3 |  |  | 1400 | 900-680
Trapezoidal Profile (set accel 2500)
Speed VL (100 steps/s)
ID | Voltage | Thrust (N) | Driver Power (mW) | Actuator Power (mW) | Duration (ms) | Actuator Energy (mJ)
M1-TVL-3 | 3V
M1-TVL-4 | 4V
M1-TVL-5 | 5V
M1-TVL-6 | 6V
Speed L (500 steps/s)
ID | Voltage | Thrust (N) | Driver Power (mW) | Actuator Power (mW) | Duration (ms) | Actuator Energy (mJ)
M1-TL-3 | 3V
M1-TL-4 | 4V
M1-TL-5 | 5V
M1-TL-6 | 6V
Speed M (2000 steps/s)
ID | Voltage | Thrust (N) | Driver Power (mW) | Actuator Power (mW) | Duration (ms) | Actuator Energy (mJ)
M1-TM-3 | 3V
M1-TM-4 | 4V
M1-TM-5 | 5V
M1-TM-6 | 6V
Speed H (5000 steps/s)
ID | Voltage | Thrust (N) | Driver Power (mW) | Actuator Power (mW) | Duration (ms) | Actuator Energy (mJ)
M1-TH-3 | 3V
M1-TH-4 | 4V
M1-TH-5 | 5V
M1-TH-6 | 6V
Speed VH (10000 steps/s)
ID | Voltage | Thrust (N) | Driver Power (mW) | Actuator Power (mW) | Duration (ms) | Actuator Energy (mJ)
M1-TVH-3 | 3V
M1-TVH-4 | 4V | 4.3 |  |  | 4400 | 1700
M1-TVH-5 | 5V
M1-TVH-6 | 6V | 5 |  |  | 4400 | 3000
S-Curve Profile (set accel 2500, set cubesteps 30)
Speed VL (100 steps/s)
ID | Voltage | Thrust (N) | Driver Power (mW) | Actuator Power (mW) | Duration (ms) | Actuator Energy (mJ)
M1-SVL-3 | 3V
M1-SVL-4 | 4V
M1-SVL-5 | 5V
M1-SVL-6 | 6V
Speed L (500 steps/s)
ID | Voltage | Thrust (N) | Driver Power (mW) | Actuator Power (mW) | Duration (ms) | Actuator Energy (mJ)
M1-SL-3 | 3V
M1-SL-4 | 4V
M1-SL-5 | 5V
M1-SL-6 | 6V
Speed M (2000 steps/s)
ID | Voltage | Thrust (N) | Driver Power (mW) | Actuator Power (mW) | Duration (ms) | Actuator Energy (mJ)
M1-SM-3 | 3V
M1-SM-4 | 4V
M1-SM-5 | 5V
M1-SM-6 | 6V
Speed H (5000 steps/s)
ID | Voltage | Thrust (N) | Driver Power (mW) | Actuator Power (mW) | Duration (ms) | Actuator Energy (mJ)
M1-SH-3 | 3V
M1-SH-4 | 4V
M1-SH-5 | 5V
M1-SH-6 | 6V
Speed VH (10000 steps/s)
ID | Voltage | Thrust (N) | Driver Power (mW) | Actuator Power (mW) | Duration (ms) | Actuator Energy (mJ)
M1-SVH-3 | 3V
M1-SVH-4 | 4V
M1-SVH-5 | 5V
M1-SVH-6 | 6V
Backdrive Test
ID | Motor State | Backdrive Force (N) | Notes
M1-BD-OFF-Spring | Disabled | 7.5 | Spring side, normal direction backdrive
M1-BD-OFF-Rigid | Disabled | 10 | Rigid side, reverse direction backdrive
Motor 1 Summary
Motor Model
Weight | ~4g
Idle Power (5V) | ___ mW
Max Thrust (best) | ___ g
Backdrive Force (disabled) | ___ g
Best Profile
Optimal Voltage
Optimal Speed

Sheet: Motor 2
Motor 2: With motor 1 we found out that Trapezoidal and S-curve profiles do not provide an advantage in terms of energy consumption with any significant improvement in their force, therefore the testing set is reduced to simply constant velocity profiles. Furthermore, it was identified that high speed motion, due to taking much shorter time, is significantly more energy efficient than doing slower movements given the nature of the Stepper motor, therefore tests at only 2 speeds are going to be done, 500 steps as a slow check, and 10000 steps/s to compare motors. in terms fo voltage, there are significant variations in the energy consumption and force delivered, so 3 voltage settings are tested, noting that the 3V set is omitted as the current stepper driver can only work over 3.8V
Constant Velocity Profile (set accel 0)
Speed L (500 steps/s) |  |  |  |  |  |  | 5000 steps
ID | Voltage | Thrust (N) | Driver Power (mW) | Actuator Power (mW) | Duration (ms) | Actuator Energy (mJ)
M2-CL-3 | 3V
M2-CL-4 | 4V | 4.1 |  | 0.4134615385 | 10400 | 4300
M2-CL-5 | 5V | 4.5 |  | 0.6346153846 | 10400 | 6600
M2-CL-6 | 6V | 6.3 |  | 0.8653846154 | 10400 | 9000
Speed VH (10000 steps/s) |  |  |  |  |  |  | 5000 steps
ID | Voltage | Thrust (N) | Driver Power (mW) | Actuator Power (mW) | Duration (ms) | Actuator Energy (mJ)
M2-CVH-3 | 3V
M2-CVH-4 | 4V | 4.9 |  | 0.3026315789 | 760 | 230
M2-CVH-5 | 5V | 5.8 |  | 0.4671052632 | 760 | 355
M2-CVH-6 | 6V | 7 |  | 0.6184210526 | 760 | 470
Constant Velocity Profile Reverse direction
Speed L (500 steps/s) |  |  |  |  |  |  | 5000 steps
ID | Voltage | Thrust (N) | Driver Power (mW) | Actuator Power (mW) | Duration (ms) | Actuator Energy (mJ)
M2-CL-3-R | 3V
M2-CL-4-R | 4V | 3.7 |  | 0.4134615385 | 10400 | 4300
M2-CL-5-R | 5V | 5.8 |  | 0.625 | 10400 | 6500
M2-CL-6-R | 6V | 6 |  | 0.8653846154 | 10400 | 9000
Speed VH (10000 steps/s) |  |  |  |  |  |  | 5000 steps
ID | Voltage | Thrust (N) | Driver Power (mW) | Actuator Power (mW) | Duration (ms) | Actuator Energy (mJ)
M2-CVH-3-R | 3V
M2-CVH-4-R | 4V | 3.9 |  | 0.3157894737 | 760 | 240
M2-CVH-5-R | 5V | 6 |  | 0.4605263158 | 760 | 350
M2-CVH-6-R | 6V | 6 |  | 0.6236842105 | 760 | 474
Backdrive Test
ID | Motor State | Backdrive Force (g) | Notes
M2-BD-OFF | Disabled | 11 | Normal direction
M2-BD-OFF-R | Disabled | 10 | Reverse direction
Motor 2 Summary
Motor Model
Weight | ~4g
Idle Power (5V) | ___ mW
Max Thrust (best) | ___ g
Backdrive Force (disabled) | ___ g
Best Profile
Optimal Voltage
Optimal Speed

Sheet: Motor 8
Motor 3: ____________________
Constant Velocity Profile (set accel 0)
Speed L (500 steps/s) |  |  |  |  |  |  | 5000 steps
ID | Voltage | Thrust (N) | Driver Power (mW) | Actuator Power (mW) | Duration (ms) | Actuator Energy (mJ)
M3-CL-3 | 3V
M3-CL-4 | 4V
M3-CL-5 | 5V
M3-CL-6 | 6V
Speed VH (10000 steps/s) |  |  |  |  |  |  | 5000 steps
ID | Voltage | Thrust (N) | Driver Power (mW) | Actuator Power (mW) | Duration (ms) | Actuator Energy (mJ)
M3-CVH-3 | 3V
M3-CVH-4 | 4V
M3-CVH-5 | 5V
M3-CVH-6 | 6V
Constant Velocity Profile Reverse direction
Speed L (500 steps/s) |  |  |  |  |  |  | 5000 steps
ID | Voltage | Thrust (N) | Driver Power (mW) | Actuator Power (mW) | Duration (ms) | Actuator Energy (mJ)
M2-CL-3-R | 3V
M2-CL-4-R | 4V
M2-CL-5-R | 5V
M2-CL-6-R | 6V
Speed VH (10000 steps/s) |  |  |  |  |  |  | 5000 steps
ID | Voltage | Thrust (N) | Driver Power (mW) | Actuator Power (mW) | Duration (ms) | Actuator Energy (mJ)
M2-CVH-3-R | 3V
M2-CVH-4-R | 4V
M2-CVH-5-R | 5V
M2-CVH-6-R | 6V
Backdrive Test
ID | Motor State | Backdrive Force (g) | Notes
M3-BD-OFF | Disabled
M3-BD-ON | Enabled (holding)
Motor 3 Summary
Motor Model
Weight | ~4g
Idle Power (5V) | ___ mW
Max Thrust (best) | ___ g
Backdrive Force (disabled) | ___ g
Best Profile
Optimal Voltage
Optimal Speed

Sheet: Motor 11A
Motor 3: ____________________
Constant Velocity Profile (set accel 0)
Speed VL (100 steps/s)
ID | Voltage | Thrust (N) | Driver Power (mW) | Actuator Power (mW) | Duration (ms) | Actuator Energy (mJ)
M3-CVL-3 | 3V
M3-CVL-4 | 4V
M3-CVL-5 | 5V
M3-CVL-6 | 6V
Speed L (500 steps/s)
ID | Voltage | Thrust (N) | Driver Power (mW) | Actuator Power (mW) | Duration (ms) | Actuator Energy (mJ)
M3-CL-3 | 3V
M3-CL-4 | 4V
M3-CL-5 | 5V
M3-CL-6 | 6V
Speed M (2000 steps/s)
ID | Voltage | Thrust (N) | Driver Power (mW) | Actuator Power (mW) | Duration (ms) | Actuator Energy (mJ)
M3-CM-3 | 3V
M3-CM-4 | 4V
M3-CM-5 | 5V
M3-CM-6 | 6V
Speed H (5000 steps/s)
ID | Voltage | Thrust (N) | Driver Power (mW) | Actuator Power (mW) | Duration (ms) | Actuator Energy (mJ)
M3-CH-3 | 3V
M3-CH-4 | 4V
M3-CH-5 | 5V
M3-CH-6 | 6V
Speed VH (10000 steps/s)
ID | Voltage | Thrust (N) | Driver Power (mW) | Actuator Power (mW) | Duration (ms) | Actuator Energy (mJ)
M3-CVH-3 | 3V
M3-CVH-4 | 4V
M3-CVH-5 | 5V
M3-CVH-6 | 6V
Trapezoidal Profile (set accel 2500)
Speed VL (100 steps/s)
ID | Voltage | Thrust (N) | Driver Power (mW) | Actuator Power (mW) | Duration (ms) | Actuator Energy (mJ)
M3-TVL-3 | 3V
M3-TVL-4 | 4V
M3-TVL-5 | 5V
M3-TVL-6 | 6V
Speed L (500 steps/s)
ID | Voltage | Thrust (N) | Driver Power (mW) | Actuator Power (mW) | Duration (ms) | Actuator Energy (mJ)
M3-TL-3 | 3V
M3-TL-4 | 4V
M3-TL-5 | 5V
M3-TL-6 | 6V
Speed M (2000 steps/s)
ID | Voltage | Thrust (N) | Driver Power (mW) | Actuator Power (mW) | Duration (ms) | Actuator Energy (mJ)
M3-TM-3 | 3V
M3-TM-4 | 4V
M3-TM-5 | 5V
M3-TM-6 | 6V
Speed H (5000 steps/s)
ID | Voltage | Thrust (N) | Driver Power (mW) | Actuator Power (mW) | Duration (ms) | Actuator Energy (mJ)
M3-TH-3 | 3V
M3-TH-4 | 4V
M3-TH-5 | 5V
M3-TH-6 | 6V
Speed VH (10000 steps/s)
ID | Voltage | Thrust (N) | Driver Power (mW) | Actuator Power (mW) | Duration (ms) | Actuator Energy (mJ)
M3-TVH-3 | 3V
M3-TVH-4 | 4V
M3-TVH-5 | 5V
M3-TVH-6 | 6V
S-Curve Profile (set accel 2500, set cubesteps 30)
Speed VL (100 steps/s)
ID | Voltage | Thrust (N) | Driver Power (mW) | Actuator Power (mW) | Duration (ms) | Actuator Energy (mJ)
M3-SVL-3 | 3V
M3-SVL-4 | 4V
M3-SVL-5 | 5V
M3-SVL-6 | 6V
Speed L (500 steps/s)
ID | Voltage | Thrust (N) | Driver Power (mW) | Actuator Power (mW) | Duration (ms) | Actuator Energy (mJ)
M3-SL-3 | 3V
M3-SL-4 | 4V
M3-SL-5 | 5V
M3-SL-6 | 6V
Speed M (2000 steps/s)
ID | Voltage | Thrust (N) | Driver Power (mW) | Actuator Power (mW) | Duration (ms) | Actuator Energy (mJ)
M3-SM-3 | 3V
M3-SM-4 | 4V
M3-SM-5 | 5V
M3-SM-6 | 6V
Speed H (5000 steps/s)
ID | Voltage | Thrust (N) | Driver Power (mW) | Actuator Power (mW) | Duration (ms) | Actuator Energy (mJ)
M3-SH-3 | 3V
M3-SH-4 | 4V
M3-SH-5 | 5V
M3-SH-6 | 6V
Speed VH (10000 steps/s)
ID | Voltage | Thrust (N) | Driver Power (mW) | Actuator Power (mW) | Duration (ms) | Actuator Energy (mJ)
M3-SVH-3 | 3V
M3-SVH-4 | 4V
M3-SVH-5 | 5V
M3-SVH-6 | 6V
Backdrive Test
ID | Motor State | Backdrive Force (g) | Notes
M3-BD-OFF | Disabled
M3-BD-ON | Enabled (holding)
Motor 3 Summary
Motor Model
Weight | ~4g
Idle Power (5V) | ___ mW
Max Thrust (best) | ___ g
Backdrive Force (disabled) | ___ g
Best Profile
Optimal Voltage
Optimal Speed

Sheet: Motor 10
Motor 3: ____________________
Constant Velocity Profile (set accel 0)
Speed VL (100 steps/s)
ID | Voltage | Thrust (N) | Driver Power (mW) | Actuator Power (mW) | Duration (ms) | Actuator Energy (mJ)
M3-CVL-3 | 3V
M3-CVL-4 | 4V
M3-CVL-5 | 5V
M3-CVL-6 | 6V
Speed L (500 steps/s)
ID | Voltage | Thrust (N) | Driver Power (mW) | Actuator Power (mW) | Duration (ms) | Actuator Energy (mJ)
M3-CL-3 | 3V
M3-CL-4 | 4V
M3-CL-5 | 5V
M3-CL-6 | 6V
Speed M (2000 steps/s)
ID | Voltage | Thrust (N) | Driver Power (mW) | Actuator Power (mW) | Duration (ms) | Actuator Energy (mJ)
M3-CM-3 | 3V
M3-CM-4 | 4V
M3-CM-5 | 5V
M3-CM-6 | 6V
Speed H (5000 steps/s)
ID | Voltage | Thrust (N) | Driver Power (mW) | Actuator Power (mW) | Duration (ms) | Actuator Energy (mJ)
M3-CH-3 | 3V
M3-CH-4 | 4V
M3-CH-5 | 5V
M3-CH-6 | 6V
Speed VH (10000 steps/s)
ID | Voltage | Thrust (N) | Driver Power (mW) | Actuator Power (mW) | Duration (ms) | Actuator Energy (mJ)
M3-CVH-3 | 3V
M3-CVH-4 | 4V
M3-CVH-5 | 5V
M3-CVH-6 | 6V
Trapezoidal Profile (set accel 2500)
Speed VL (100 steps/s)
ID | Voltage | Thrust (N) | Driver Power (mW) | Actuator Power (mW) | Duration (ms) | Actuator Energy (mJ)
M3-TVL-3 | 3V
M3-TVL-4 | 4V
M3-TVL-5 | 5V
M3-TVL-6 | 6V
Speed L (500 steps/s)
ID | Voltage | Thrust (N) | Driver Power (mW) | Actuator Power (mW) | Duration (ms) | Actuator Energy (mJ)
M3-TL-3 | 3V
M3-TL-4 | 4V
M3-TL-5 | 5V
M3-TL-6 | 6V
Speed M (2000 steps/s)
ID | Voltage | Thrust (N) | Driver Power (mW) | Actuator Power (mW) | Duration (ms) | Actuator Energy (mJ)
M3-TM-3 | 3V
M3-TM-4 | 4V
M3-TM-5 | 5V
M3-TM-6 | 6V
Speed H (5000 steps/s)
ID | Voltage | Thrust (N) | Driver Power (mW) | Actuator Power (mW) | Duration (ms) | Actuator Energy (mJ)
M3-TH-3 | 3V
M3-TH-4 | 4V
M3-TH-5 | 5V
M3-TH-6 | 6V
Speed VH (10000 steps/s)
ID | Voltage | Thrust (N) | Driver Power (mW) | Actuator Power (mW) | Duration (ms) | Actuator Energy (mJ)
M3-TVH-3 | 3V
M3-TVH-4 | 4V
M3-TVH-5 | 5V
M3-TVH-6 | 6V
S-Curve Profile (set accel 2500, set cubesteps 30)
Speed VL (100 steps/s)
ID | Voltage | Thrust (N) | Driver Power (mW) | Actuator Power (mW) | Duration (ms) | Actuator Energy (mJ)
M3-SVL-3 | 3V
M3-SVL-4 | 4V
M3-SVL-5 | 5V
M3-SVL-6 | 6V
Speed L (500 steps/s)
ID | Voltage | Thrust (N) | Driver Power (mW) | Actuator Power (mW) | Duration (ms) | Actuator Energy (mJ)
M3-SL-3 | 3V
M3-SL-4 | 4V
M3-SL-5 | 5V
M3-SL-6 | 6V
Speed M (2000 steps/s)
ID | Voltage | Thrust (N) | Driver Power (mW) | Actuator Power (mW) | Duration (ms) | Actuator Energy (mJ)
M3-SM-3 | 3V
M3-SM-4 | 4V
M3-SM-5 | 5V
M3-SM-6 | 6V
Speed H (5000 steps/s)
ID | Voltage | Thrust (N) | Driver Power (mW) | Actuator Power (mW) | Duration (ms) | Actuator Energy (mJ)
M3-SH-3 | 3V
M3-SH-4 | 4V
M3-SH-5 | 5V
M3-SH-6 | 6V
Speed VH (10000 steps/s)
ID | Voltage | Thrust (N) | Driver Power (mW) | Actuator Power (mW) | Duration (ms) | Actuator Energy (mJ)
M3-SVH-3 | 3V
M3-SVH-4 | 4V
M3-SVH-5 | 5V
M3-SVH-6 | 6V
Backdrive Test
ID | Motor State | Backdrive Force (g) | Notes
M3-BD-OFF | Disabled
M3-BD-ON | Enabled (holding)
Motor 3 Summary
Motor Model
Weight | ~4g
Idle Power (5V) | ___ mW
Max Thrust (best) | ___ g
Backdrive Force (disabled) | ___ g
Best Profile
Optimal Voltage
Optimal Speed

Sheet: Motor 11D
Motor 3: ____________________
Constant Velocity Profile (set accel 0)
Speed VL (100 steps/s)
ID | Voltage | Thrust (N) | Driver Power (mW) | Actuator Power (mW) | Duration (ms) | Actuator Energy (mJ)
M3-CVL-3 | 3V
M3-CVL-4 | 4V
M3-CVL-5 | 5V
M3-CVL-6 | 6V
Speed L (500 steps/s)
ID | Voltage | Thrust (N) | Driver Power (mW) | Actuator Power (mW) | Duration (ms) | Actuator Energy (mJ)
M3-CL-3 | 3V
M3-CL-4 | 4V
M3-CL-5 | 5V
M3-CL-6 | 6V
Speed M (2000 steps/s)
ID | Voltage | Thrust (N) | Driver Power (mW) | Actuator Power (mW) | Duration (ms) | Actuator Energy (mJ)
M3-CM-3 | 3V
M3-CM-4 | 4V
M3-CM-5 | 5V
M3-CM-6 | 6V
Speed H (5000 steps/s)
ID | Voltage | Thrust (N) | Driver Power (mW) | Actuator Power (mW) | Duration (ms) | Actuator Energy (mJ)
M3-CH-3 | 3V
M3-CH-4 | 4V
M3-CH-5 | 5V
M3-CH-6 | 6V
Speed VH (10000 steps/s)
ID | Voltage | Thrust (N) | Driver Power (mW) | Actuator Power (mW) | Duration (ms) | Actuator Energy (mJ)
M3-CVH-3 | 3V
M3-CVH-4 | 4V
M3-CVH-5 | 5V
M3-CVH-6 | 6V
Trapezoidal Profile (set accel 2500)
Speed VL (100 steps/s)
ID | Voltage | Thrust (N) | Driver Power (mW) | Actuator Power (mW) | Duration (ms) | Actuator Energy (mJ)
M3-TVL-3 | 3V
M3-TVL-4 | 4V
M3-TVL-5 | 5V
M3-TVL-6 | 6V
Speed L (500 steps/s)
ID | Voltage | Thrust (N) | Driver Power (mW) | Actuator Power (mW) | Duration (ms) | Actuator Energy (mJ)
M3-TL-3 | 3V
M3-TL-4 | 4V
M3-TL-5 | 5V
M3-TL-6 | 6V
Speed M (2000 steps/s)
ID | Voltage | Thrust (N) | Driver Power (mW) | Actuator Power (mW) | Duration (ms) | Actuator Energy (mJ)
M3-TM-3 | 3V
M3-TM-4 | 4V
M3-TM-5 | 5V
M3-TM-6 | 6V
Speed H (5000 steps/s)
ID | Voltage | Thrust (N) | Driver Power (mW) | Actuator Power (mW) | Duration (ms) | Actuator Energy (mJ)
M3-TH-3 | 3V
M3-TH-4 | 4V
M3-TH-5 | 5V
M3-TH-6 | 6V
Speed VH (10000 steps/s)
ID | Voltage | Thrust (N) | Driver Power (mW) | Actuator Power (mW) | Duration (ms) | Actuator Energy (mJ)
M3-TVH-3 | 3V
M3-TVH-4 | 4V
M3-TVH-5 | 5V
M3-TVH-6 | 6V
S-Curve Profile (set accel 2500, set cubesteps 30)
Speed VL (100 steps/s)
ID | Voltage | Thrust (N) | Driver Power (mW) | Actuator Power (mW) | Duration (ms) | Actuator Energy (mJ)
M3-SVL-3 | 3V
M3-SVL-4 | 4V
M3-SVL-5 | 5V
M3-SVL-6 | 6V
Speed L (500 steps/s)
ID | Voltage | Thrust (N) | Driver Power (mW) | Actuator Power (mW) | Duration (ms) | Actuator Energy (mJ)
M3-SL-3 | 3V
M3-SL-4 | 4V
M3-SL-5 | 5V
M3-SL-6 | 6V
Speed M (2000 steps/s)
ID | Voltage | Thrust (N) | Driver Power (mW) | Actuator Power (mW) | Duration (ms) | Actuator Energy (mJ)
M3-SM-3 | 3V
M3-SM-4 | 4V
M3-SM-5 | 5V
M3-SM-6 | 6V
Speed H (5000 steps/s)
ID | Voltage | Thrust (N) | Driver Power (mW) | Actuator Power (mW) | Duration (ms) | Actuator Energy (mJ)
M3-SH-3 | 3V
M3-SH-4 | 4V
M3-SH-5 | 5V
M3-SH-6 | 6V
Speed VH (10000 steps/s)
ID | Voltage | Thrust (N) | Driver Power (mW) | Actuator Power (mW) | Duration (ms) | Actuator Energy (mJ)
M3-SVH-3 | 3V
M3-SVH-4 | 4V
M3-SVH-5 | 5V
M3-SVH-6 | 6V
Backdrive Test
ID | Motor State | Backdrive Force (g) | Notes
M3-BD-OFF | Disabled
M3-BD-ON | Enabled (holding)
Motor 3 Summary
Motor Model
Weight | ~4g
Idle Power (5V) | ___ mW
Max Thrust (best) | ___ g
Backdrive Force (disabled) | ___ g
Best Profile
Optimal Voltage
Optimal Speed
