cvalenciaMEMSYS/UniversalMotorModule/(commit log)

2026-01-06 Project rename to Universal Motor Module
2026-01-06 wiring corrected?
2026-01-06 Reworked structure poseidon ready + status LED
    [DriverFactory.cpp, DriverFactory.h, IMotorDriver.h, MotorController.cpp, MotorController.h, PinConfig.h, StatusLED.cpp, StatusLED.h]
2026-01-07 better error detection and status handling
    [MotorController.cpp, MotorController.h, StatusLED.cpp, main.cpp]
2026-01-07 Velocity profiles implemented
2026-01-07 Long bug fix session and docs update. functionality added to work with the H bridge.
    [DCMotorDriver.cpp, DCMotorDriver.h, DriverFactory.cpp, IMotorDriver.h, MotorController.cpp, TMC2208Driver.cpp, TMC2208Driver.h]
2026-01-07 Stepper driver migrated to hardware timers for motor control. max speed being 300rpm issue investigation
    [MotorController.cpp, StatusLED.cpp, StatusLED.h, TMC2208Driver.cpp, TMC2208Driver.h, TMC2209Driver.cpp, TMC2209Driver.h]
2026-01-14 Documentation updated. New LED sequence at startup. Testing documentation updated
2026-01-14 final hardware validation fixes for stepper motor drivers
    [StatusLED.cpp, TMC2208Driver.cpp, TMC2209Driver.cpp]
2026-01-16 Base Testing scripts complete
    [Energy_Test_Results.xlsx]
2026-01-16 Failed attempt at full suite automation due to JS Issues, resorting to a different approach
    [orchestrator.py]
2026-01-19 M1 and M2 tested
    [Energy_Test_Results.xlsx]
2026-01-30 First round of testing done, M1 M2 and partial M8. Develope ddata analysis tools.
    [Energy_Test_Results.xlsx, M1_detailed_metrics.csv, M2_detailed_metrics.csv]
2026-01-30 Data update including M1 backdriving forces
    [M1_detailed_metrics.csv]
2026-02-04 Fixed DC motor drivign logic and pinout
    [DCMotorDriver.cpp, DCMotorDriver.h, MotorController.cpp, PinConfig.h]
2026-02-09 Summary data re ordering and new data added with driver STSPIN220
    [M1_detailed_metrics.csv, M2_detailed_metrics.csv]
2026-02-09 Added arbitrary dataset plotting capabilities + plot for best option motor 2 new driver
2026-02-12 Added support for DC motors data analysis
2026-02-17 Added test results for DC motors
    [D1_detailed_metrics.csv, D1_fixed_detailed_metrics.csv, D2_ConstantLoad300g_detailed_metrics.csv, D2_ConstantLoad580g_detailed_metrics.csv, D2_detailed_metrics.csv, D3_detailed_metrics.csv]
2026-02-24 Added simple stepper motor control interface without FD
2026-03-02 Force deflection setup V2 and V3 naming deprecation, now using the standard naming NoMotor and MotorAndForce used in the mechanical tooling repo. Arduino bug fixes that blocked small steps sizes
    [ForceDeflection_MotorAndForces.py, ForceDeflection_NoMotor.py, fd_arduino.ino]
2026-03-11 Readme update. Added native support for new STSPIN220 driver
2026-03-26 Added D4 motor tests. Updated analysis tool
    [D4_detailed_metrics.csv]
2026-04-07 Fix audit findings: doc corrections, input buffer limit, STSPIN220 detection docs
    Agent-Logs-Url: https://github.com/cvalenciaMEMSYS/UniversalMotorModule/sessions/dc694021-f72a-4873-808d-48c41601afb2
    [main.cpp]
2026-04-07 Add STM32 Nucleo L031K6 DC motor portability guide
    Agent-Logs-Url: https://github.com/cvalenciaMEMSYS/UniversalMotorModule/sessions/fc50678e-a7d8-47c6-9b8d-247285990a51
2026-04-07 Update audit report to reflect current status and fix remaining doc inaccuracies
    Agent-Logs-Url: https://github.com/cvalenciaMEMSYS/UniversalMotorModule/sessions/575f5822-45d7-49ab-8cd5-ccd926b28a06
2026-04-14 STM32 basic port
2026-04-16 Updated STM32 version - Simplified code as all modules can be handeled with the same commands, no special distinction per module needed with customs switch cases
2026-04-16 Updated STM32 folder readme
2026-06-01 Updated Platform.io framework to force the use of 2.x instead of 3.x if installed
2026-06-18 Motor cycle 100 run, for TP021 S4.F2
